NikolaRistanovic/PPPMTV/resources/IMG_20210708_203529.jpg

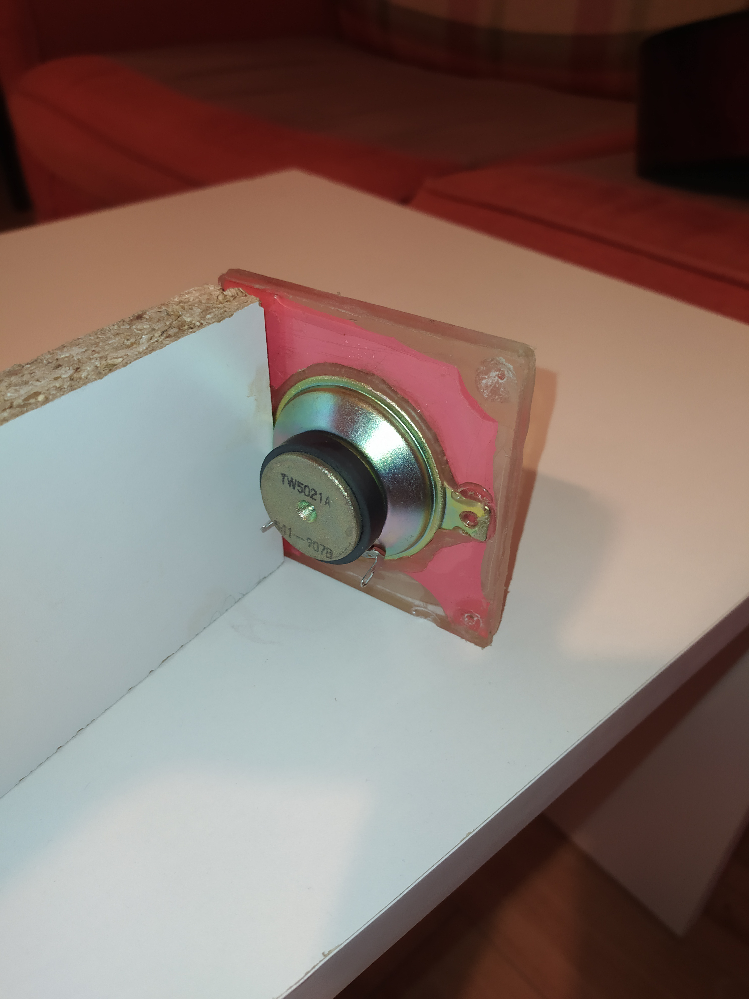
resources/IMG_20210708_203529.jpg
