NikolaRistanovic/PPPMTV/resources/IMG_20210708_203515.jpg

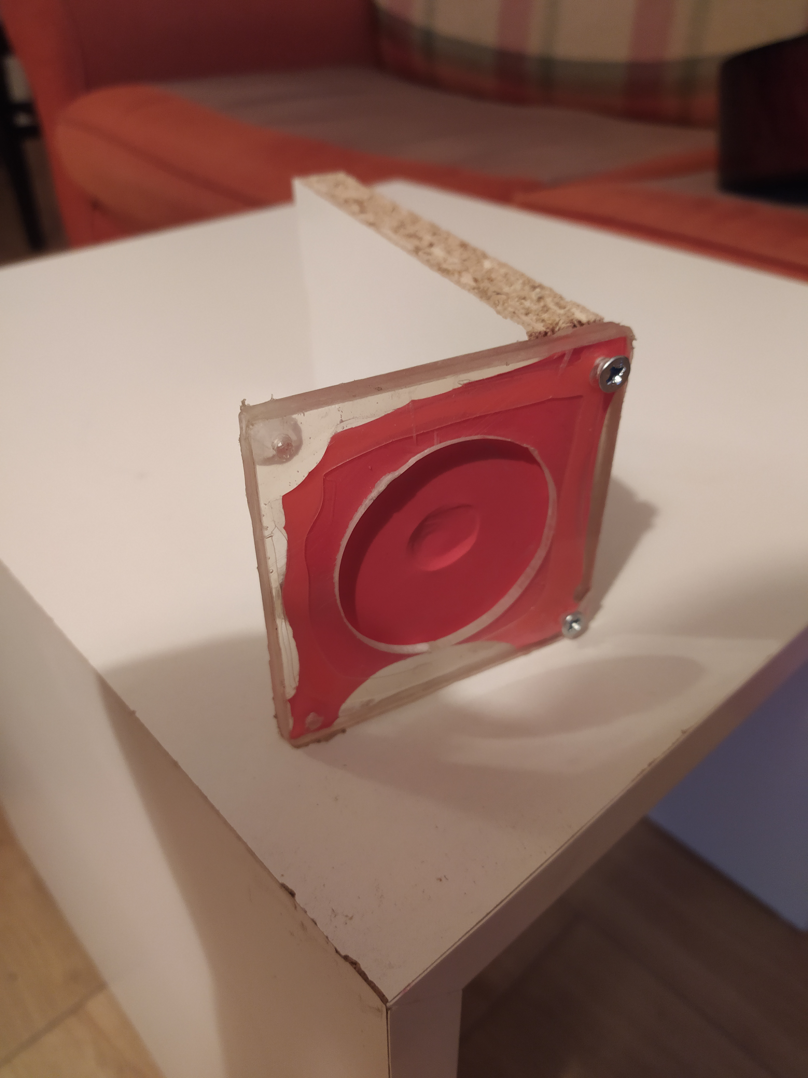
resources/IMG_20210708_203515.jpg
