NikolaRistanovic/PPPMTV/resources/Diagrams/Transceiver.png

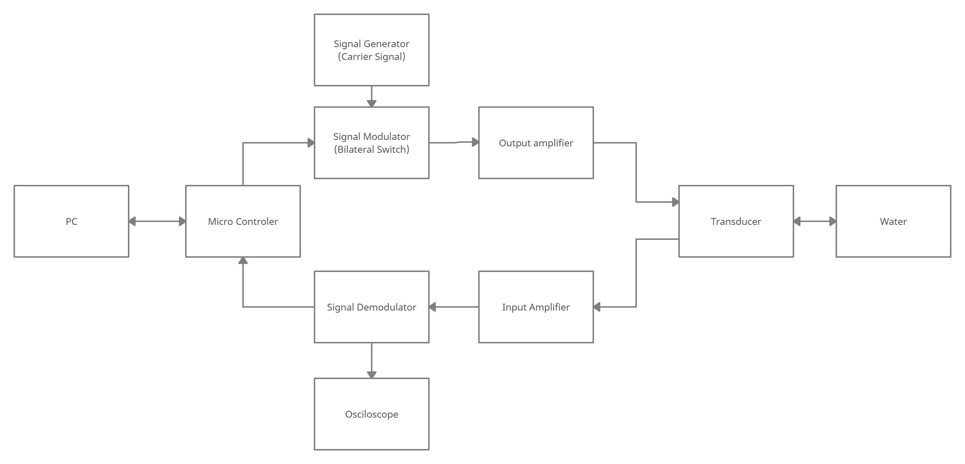
resources/Diagrams/Transceiver.png
