NikolaRistanovic/PPPMTV/resources/Schematics/filter.png

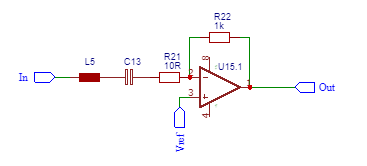
resources/Schematics/filter.png
