NikolaRistanovic/PPPMTV/resources/Schematics/Schematic_Petnica PPPMTV_2021-06-24.png

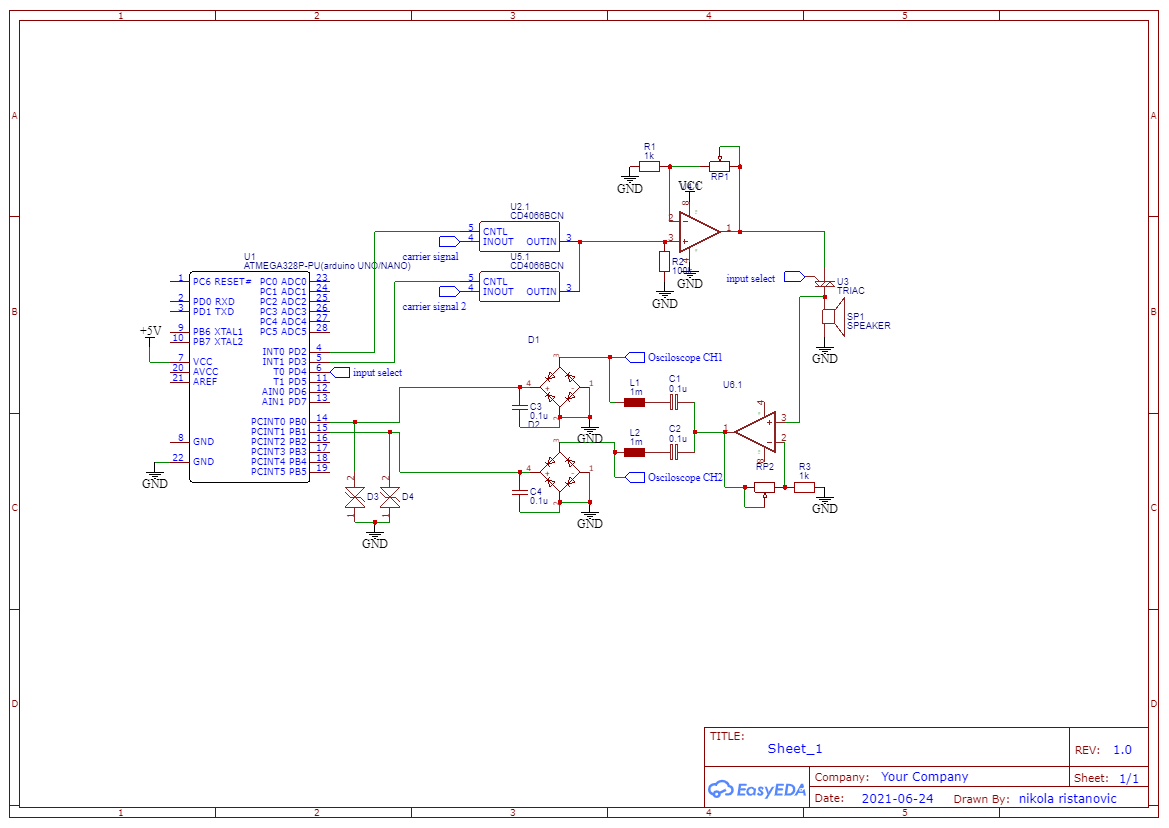
resources/Schematics/Schematic_Petnica PPPMTV_2021-06-24.png
