NikolaRistanovic/PPPMTV/resources/Schematics/Schematic_Petnica PPPMTV_2021-06-28.png

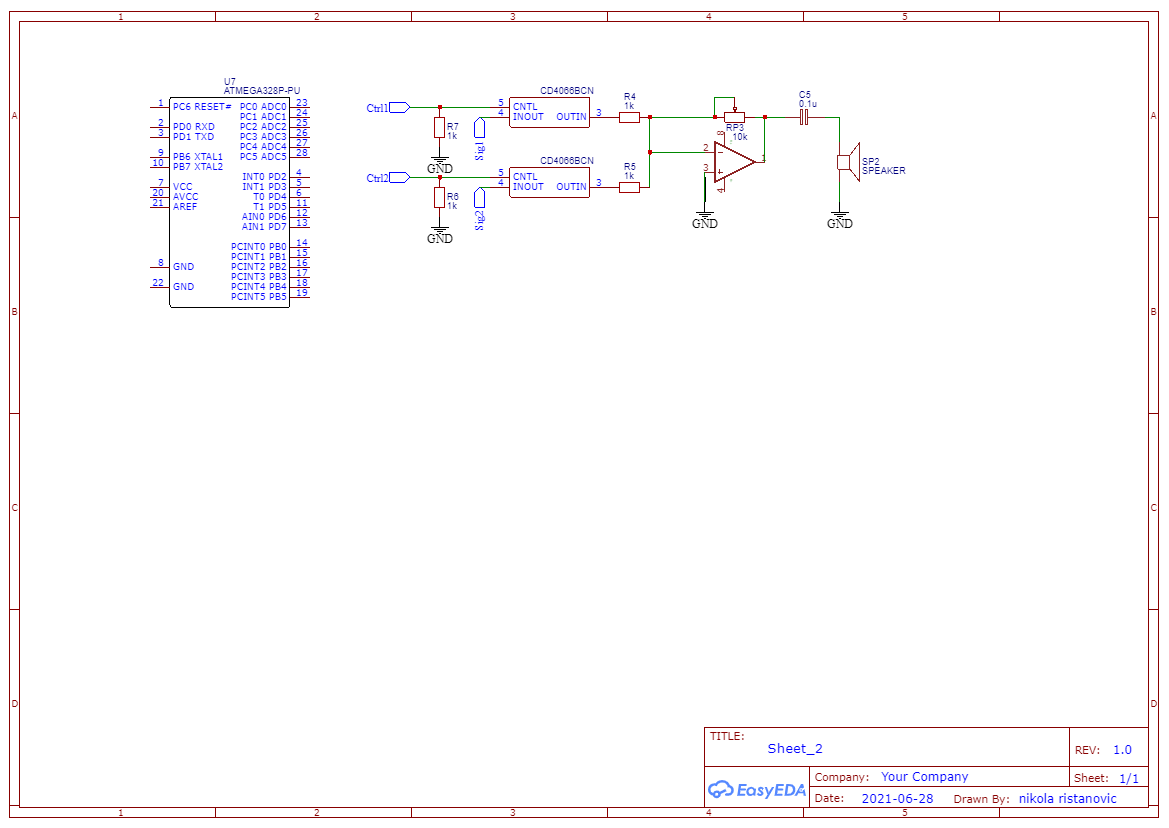
resources/Schematics/Schematic_Petnica PPPMTV_2021-06-28.png
