NikolaRistanovic/PPPMTV/resources/Schematics/Schematic_Petnica PPPMTV_2021-06-30.png

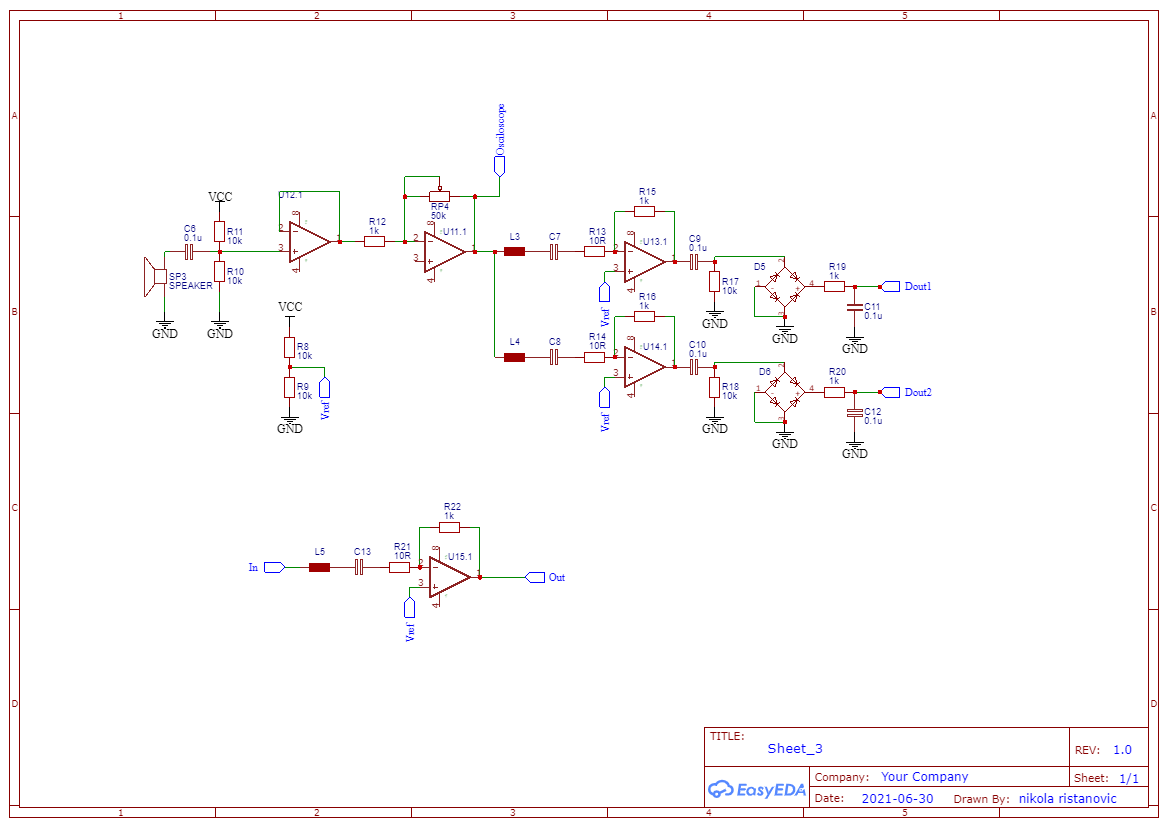
resources/Schematics/Schematic_Petnica PPPMTV_2021-06-30.png
