NikolaRistanovic/PPPMTV/resources/untitled (1).png

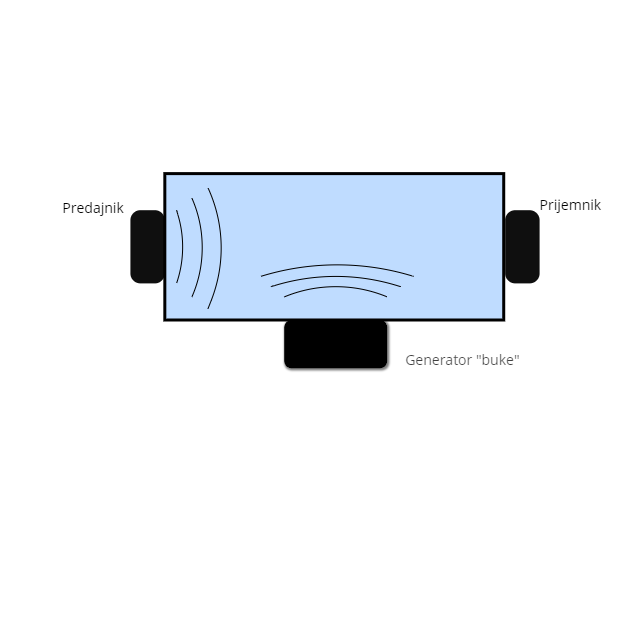
resources/untitled (1).png
