NikolaRistanovic/PPPMTV/resources/untitled (2).png

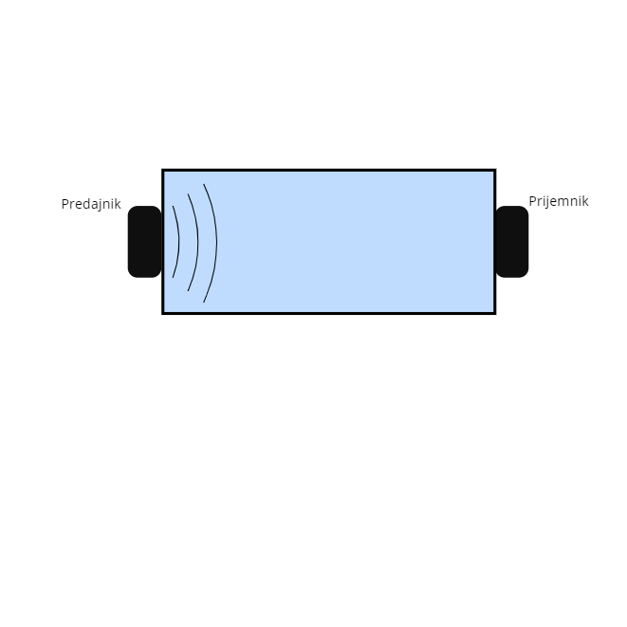
resources/untitled (2).png
