NikolaRistanovic/PPPMTV/resources/Untitled.png

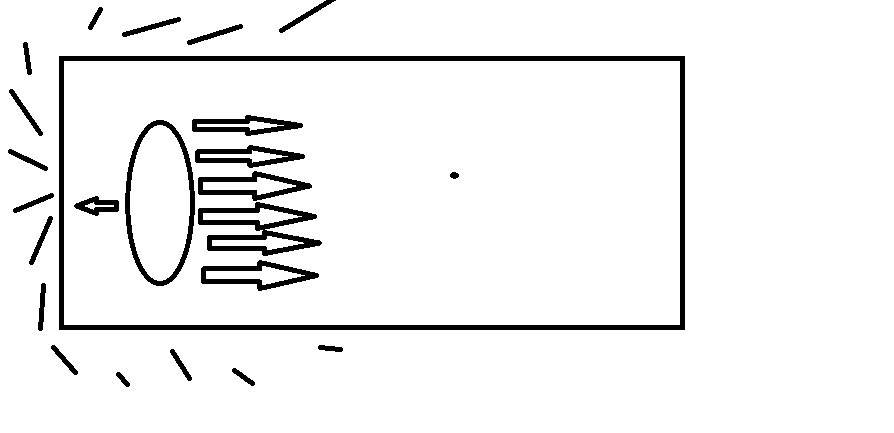
resources/Untitled.png
