NikolaRistanovic/PPPMTV/(list of files, cad)

Other CAD files:
resources/Skica1.skp
