NikolaRistanovic/PPPMTV/resources/Schematics/Schematic_Petnica PPPMTV_2021-06-30.pdf

# U4.1V+ V-

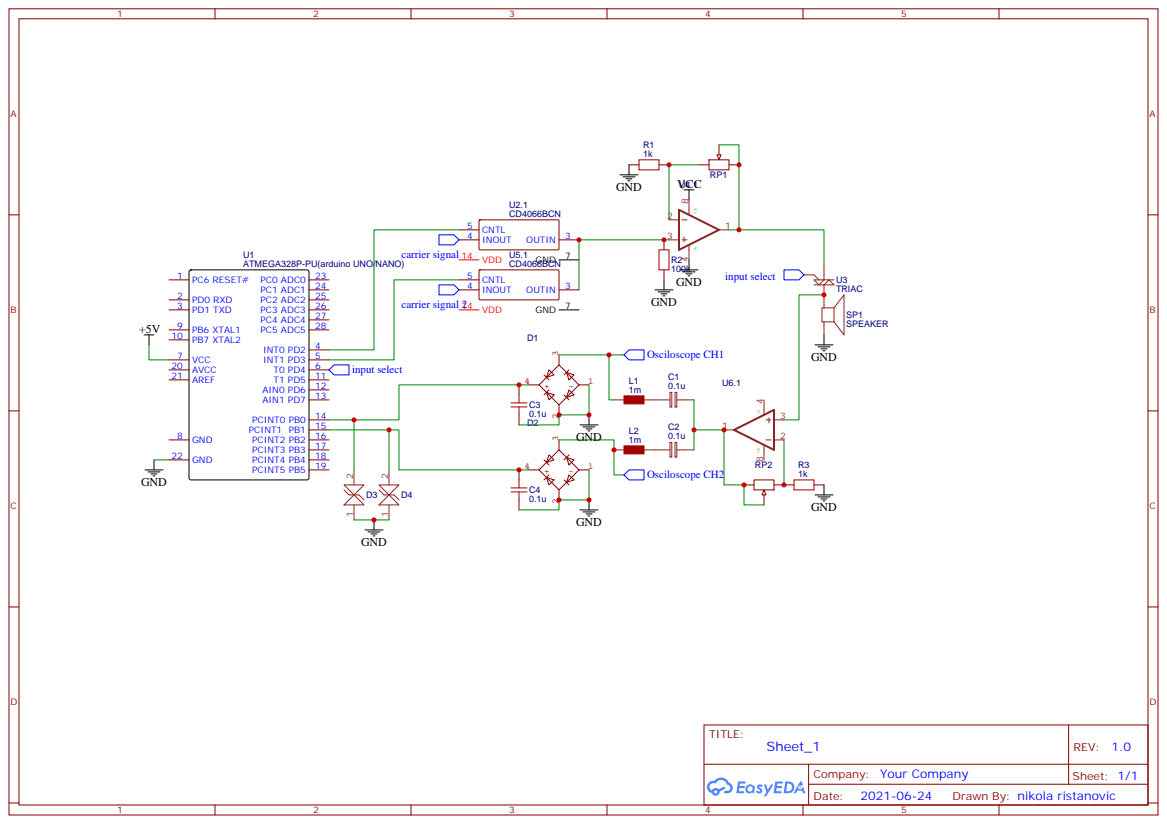
[picture p35: page 1]

Drawn By: nikola ristanovic

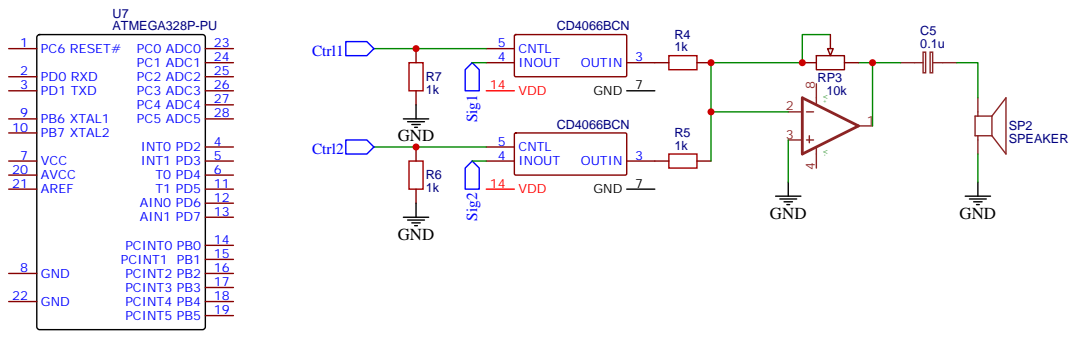
[picture p36: page 2]

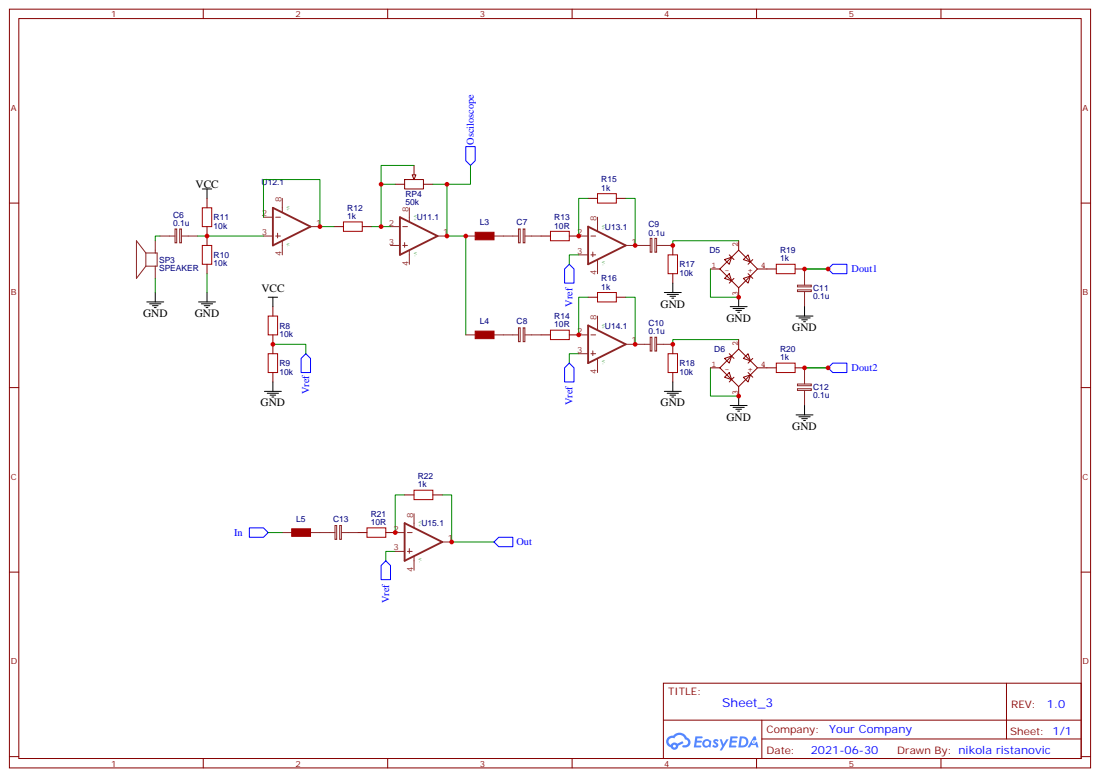
[picture p37: page 3]
