NikolaRistanovic/PPPMTV/(commit log)

2021-06-24 First version
    [Skica1.skp]
2021-06-28 Update Added references Added a schematic of power amplifier/signal modulator Added context of previous research
2021-06-29 Update Added formulas Added modulating and demodulatin circuit diagrams Added required aparature list
